jeng/asm6502/hardware/prototype_photos/FJ4s4CEXIAc8fG_.jpg

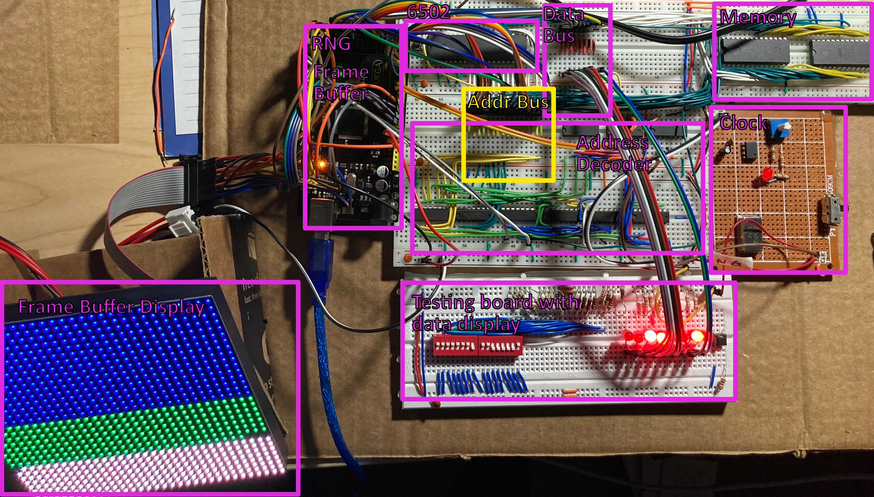
hardware/prototype_photos/FJ4s4CEXIAc8fG_.jpg
