jeng/asm6502/hardware/prototype_photos/IMG-2354.jpg

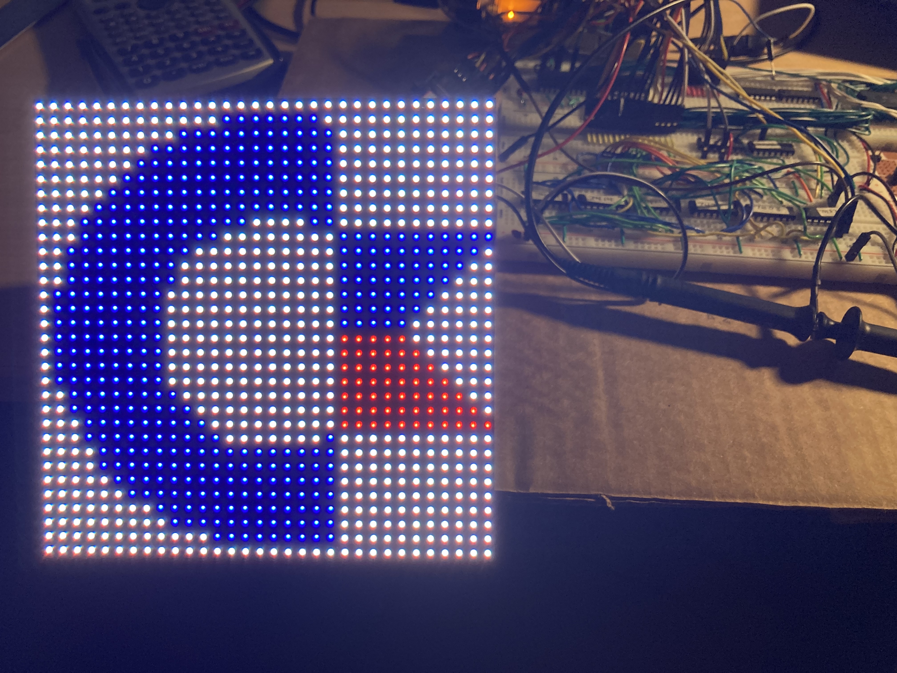
hardware/prototype_photos/IMG-2354.jpg
