jeng/asm6502/hardware/prototype_photos/bus_probe.png

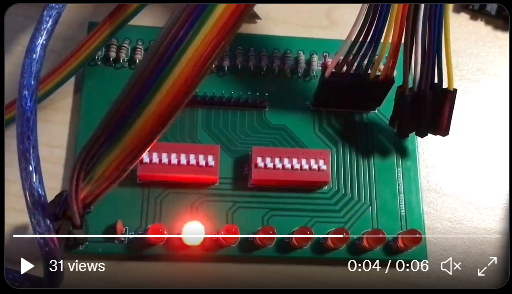
hardware/prototype_photos/bus_probe.png
