jeng/asm6502/hardware/prototype_photos/IMG-2370.jpg

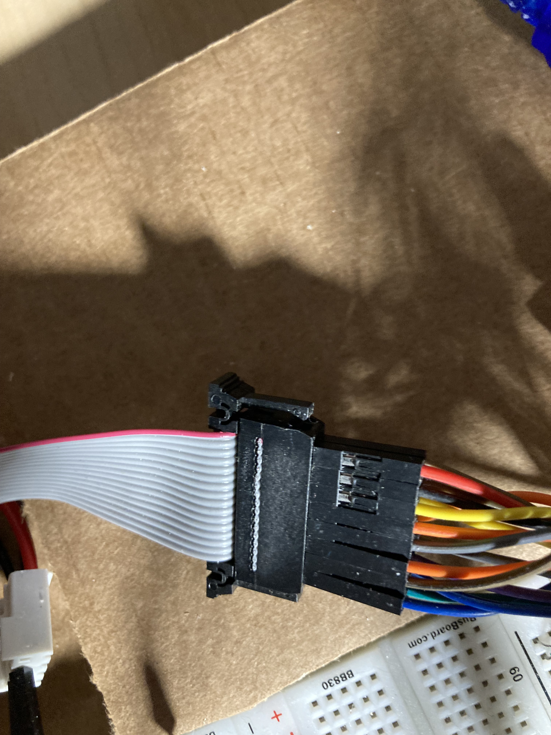
hardware/prototype_photos/IMG-2370.jpg
