jeng/asm6502/hardware/prototype_photos/v9AddressLogicFrameBuffer.png

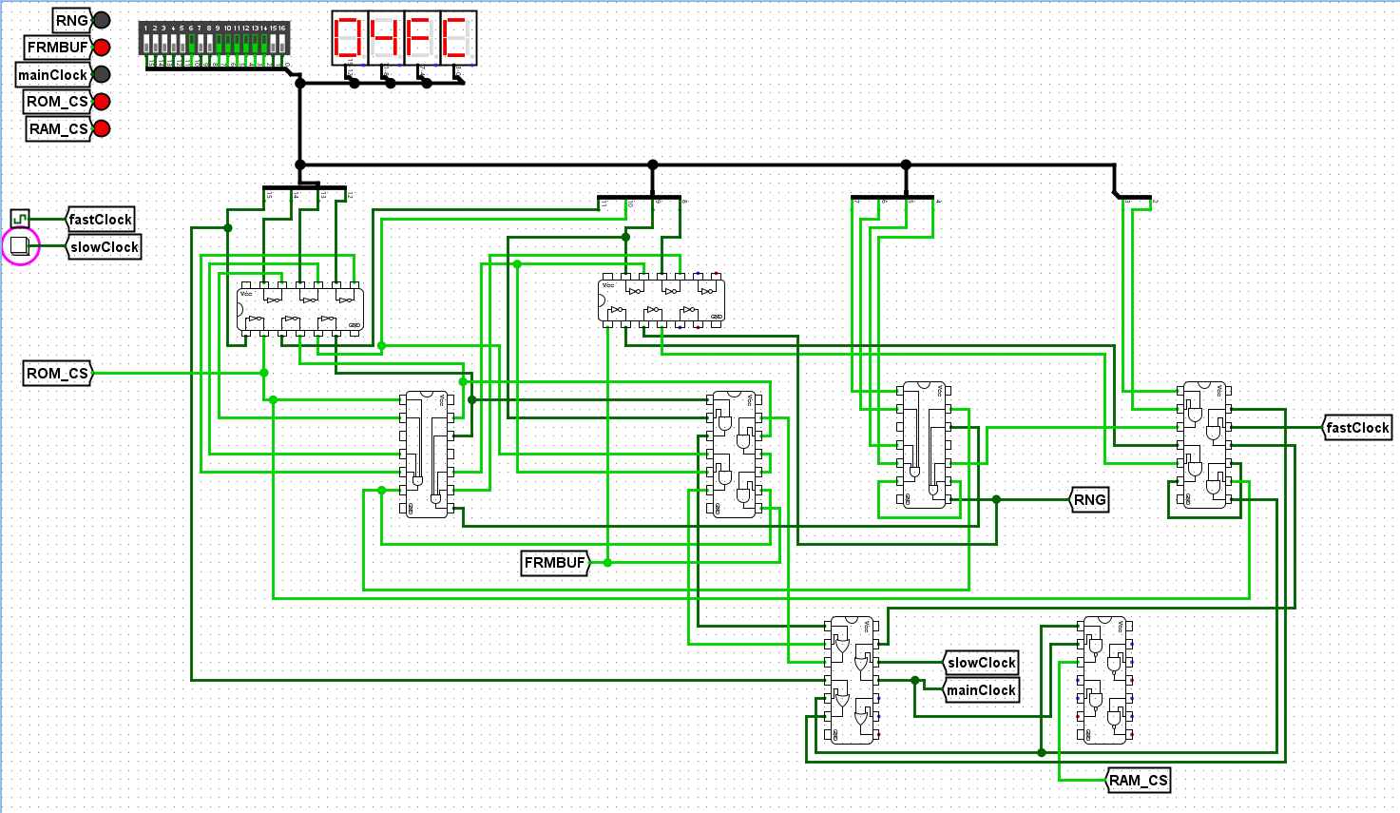
hardware/prototype_photos/v9AddressLogicFrameBuffer.png
