jeng/asm6502/hardware/simulations/addressBus.png

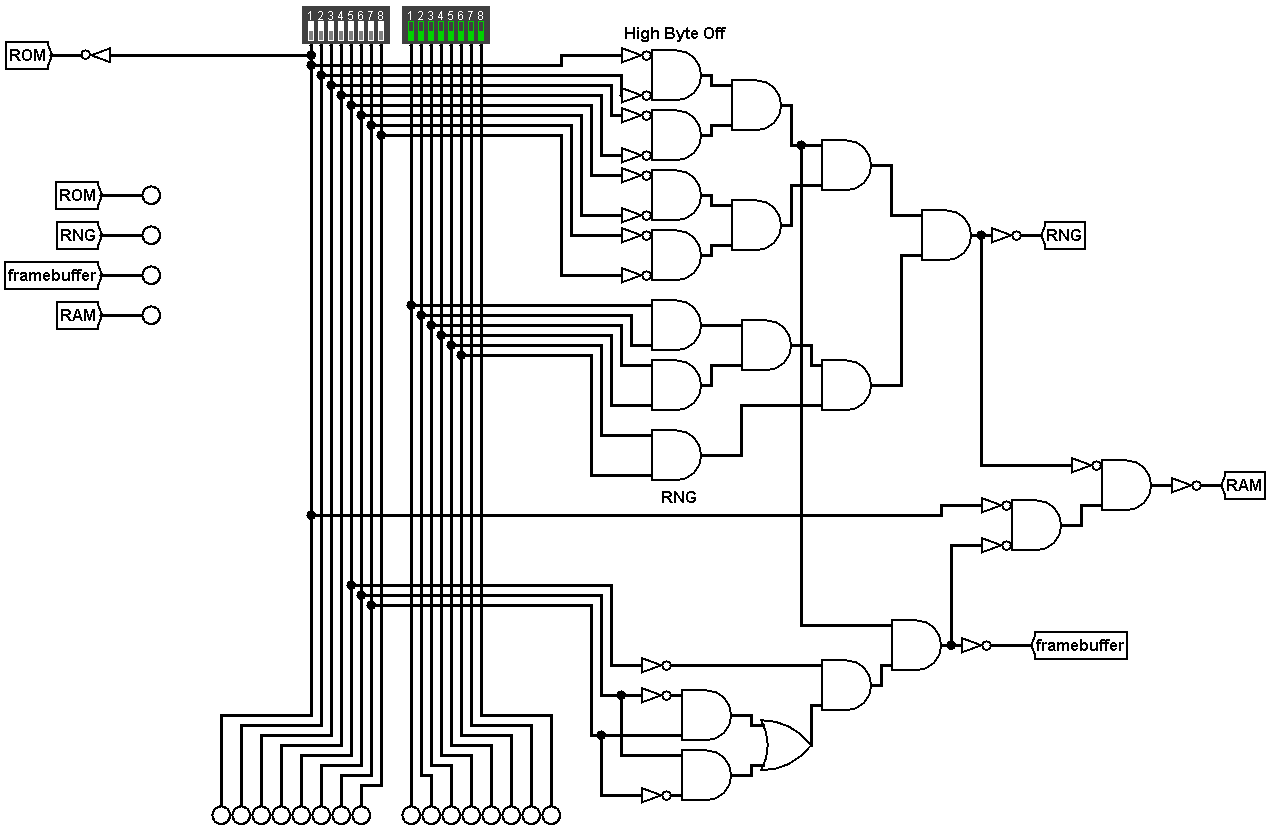
hardware/simulations/addressBus.png
