jeng/asm6502/hardware/simulations/addressBusV3.png

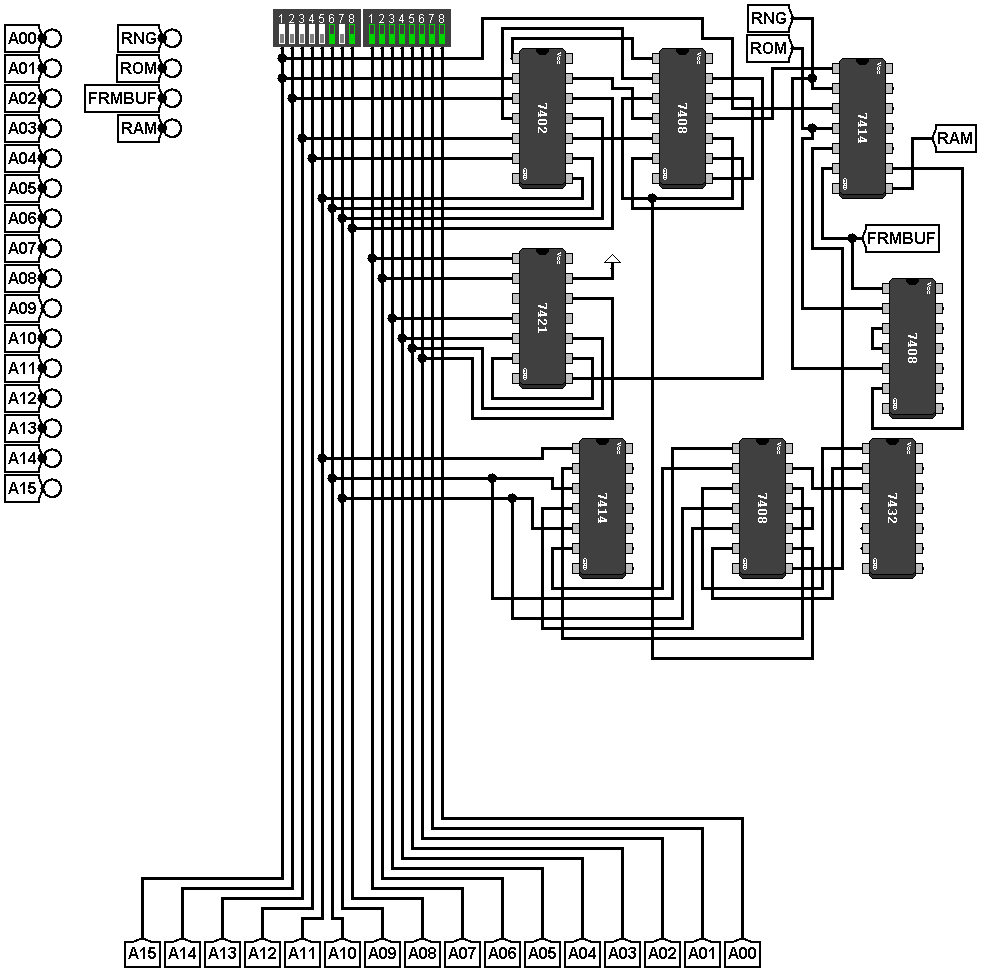
hardware/simulations/addressBusV3.png
