jeng/asm6502/hardware/simulations/addressBusV4.png

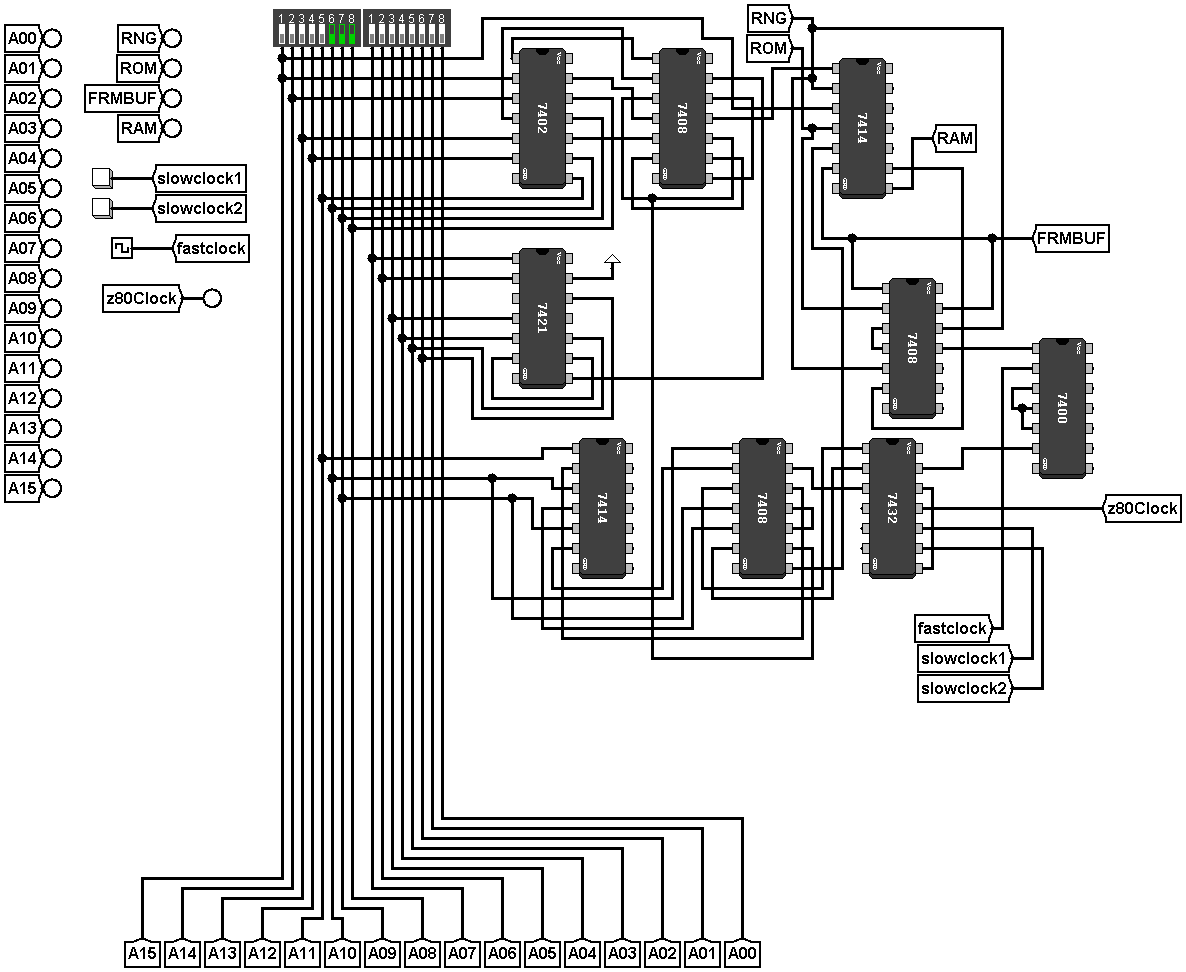
hardware/simulations/addressBusV4.png
