jeng/asm6502/hardware/simulations/memoryMapChipSelectors.png

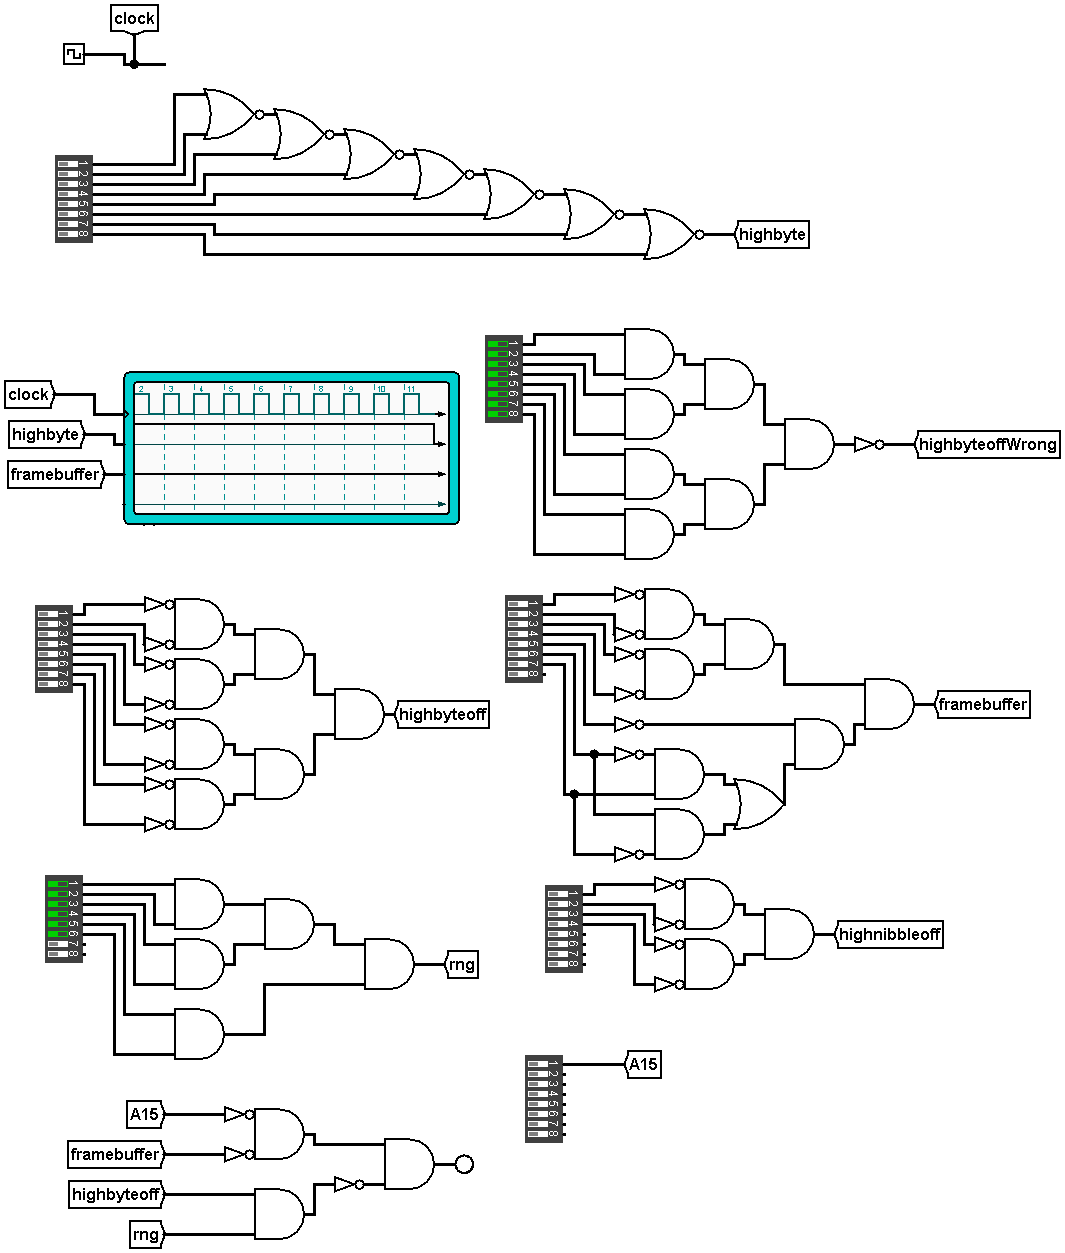
hardware/simulations/memoryMapChipSelectors.png
