jeng/asm6502/hardware/simulations/ram_rom_rng_tied_to_clock.png

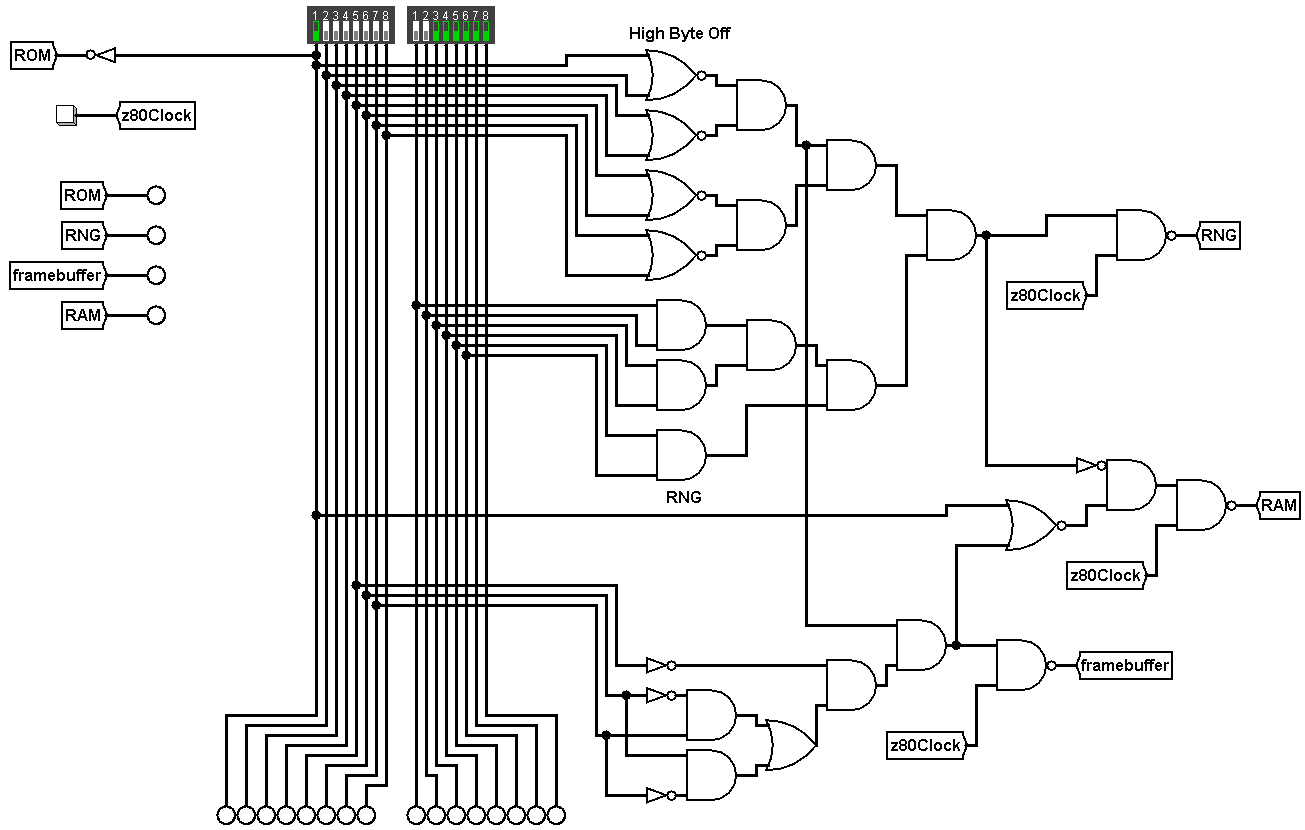
hardware/simulations/ram_rom_rng_tied_to_clock.png
