jeng/asm6502/hardware/simulations/ttlAddScrShot.png

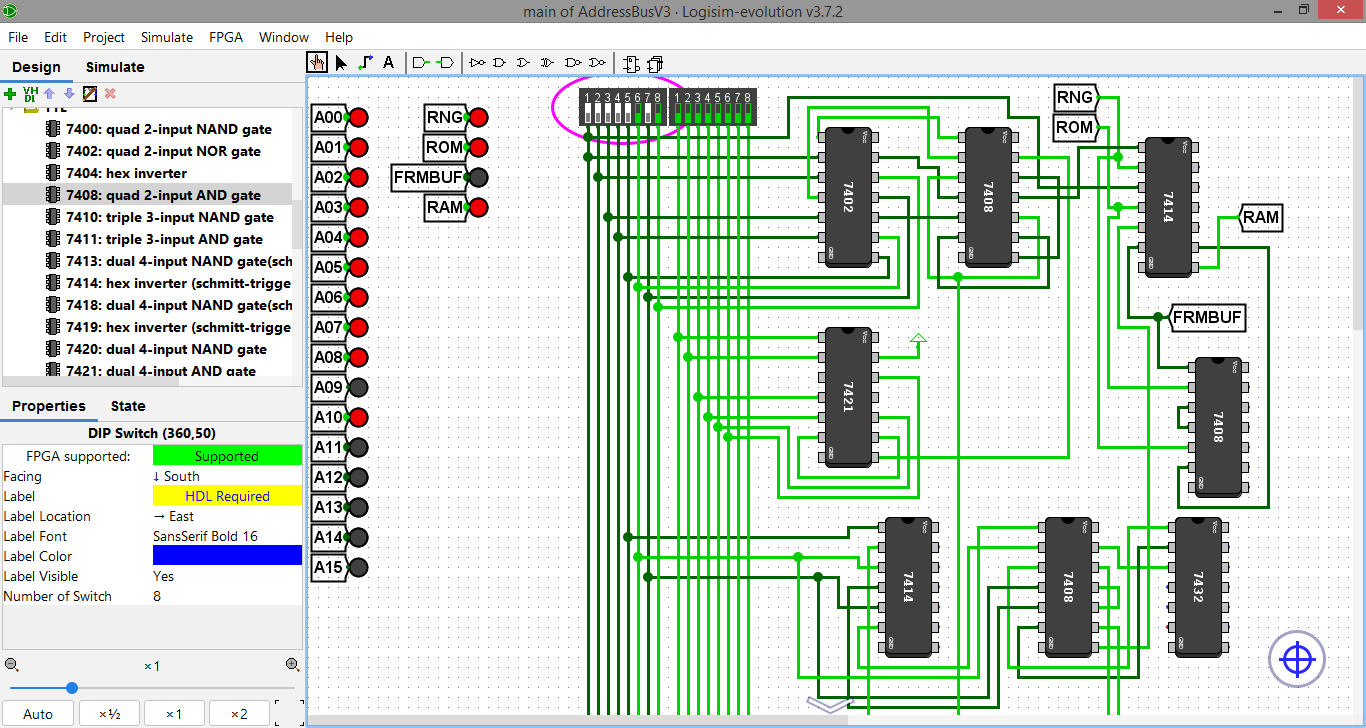
hardware/simulations/ttlAddScrShot.png
