jeng/asm6502/hardware/schematics/bus_probe/LeProbe.pdf

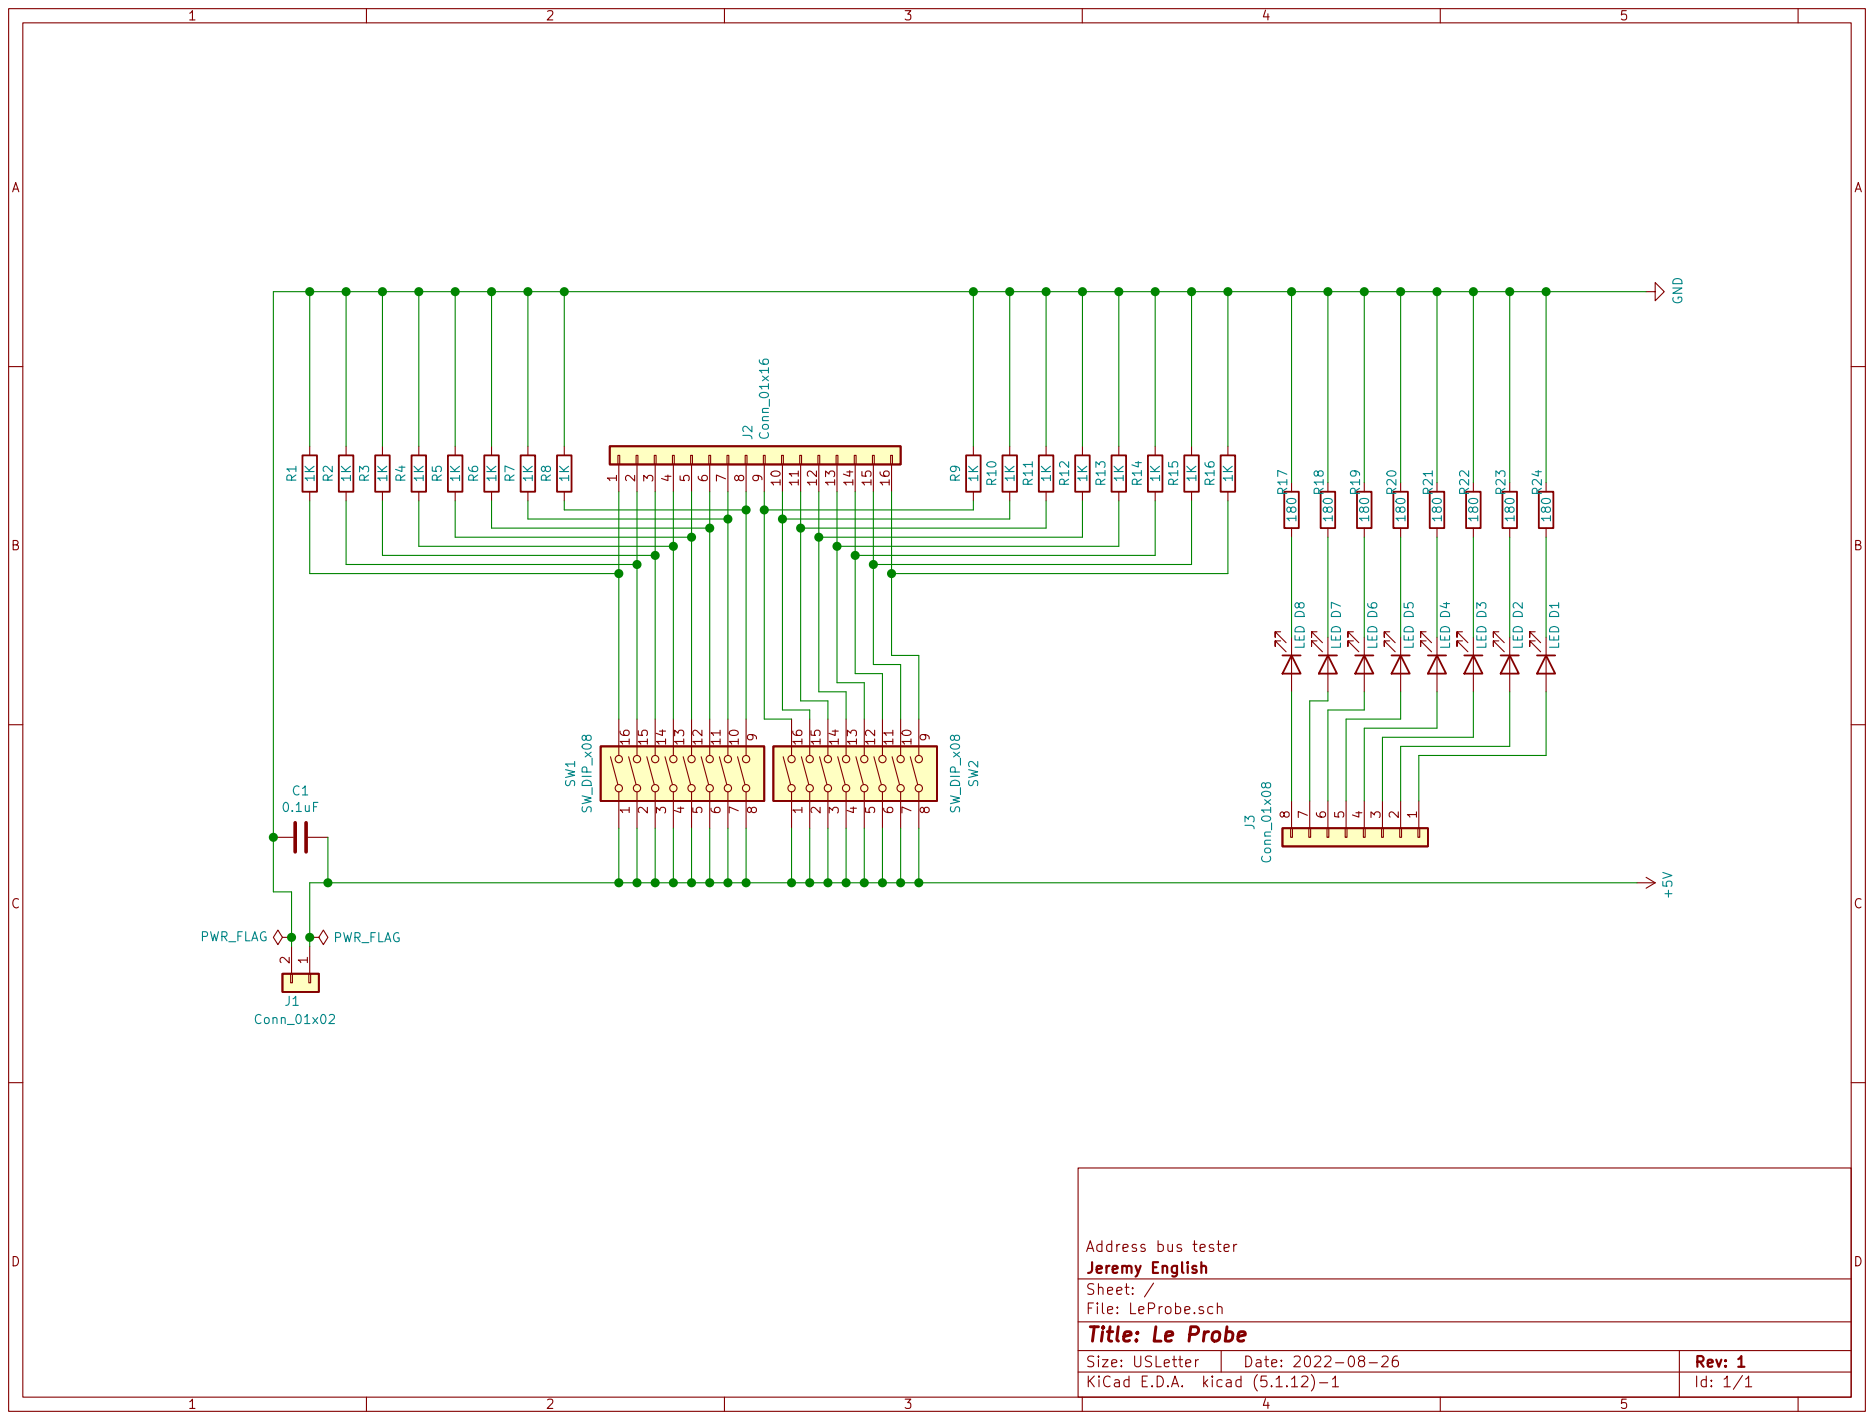
[picture p15: page 1]

Id: 1/1 Title: Le Probe
