jeng/asm6502/hardware/schematics/cpu/cpu.pdf

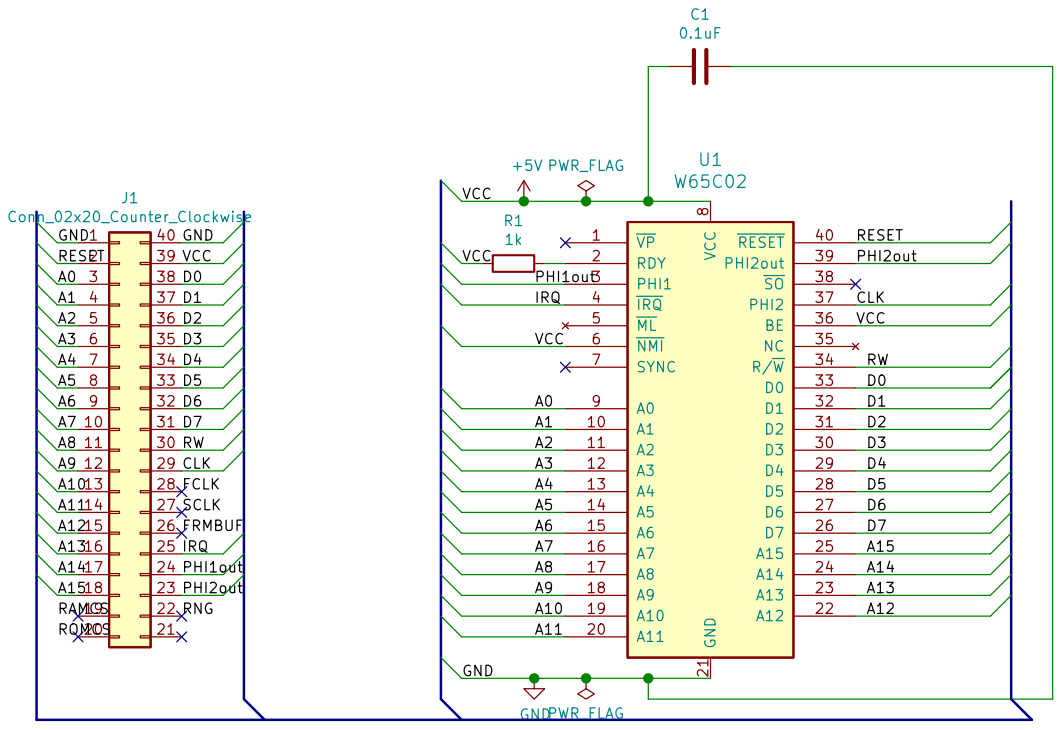
[picture p16: page 1]

8 A0 9 A1 10 A11 20 D3 30 RESET 40 A2 11 GND 21 D2 31 A3 12 A12 22 D1 32 A4 13 A13 23 D0 33 A5 14 A14 24 R/W 34 A6 15 A15 25 NC 35 A7 16 D7 26 BE 36 A8 17 D6 27 PHI2 37 A9 18 D5 28 SO 38 A10 19 D4 29 PHI2out 39 U1 W65C02
PWR_FLAG

File: cpu.sch Sheet: / Jeremy English jhe@jeremyenglish.org Hardware version of the 6502 XScreenSaver Module

Id: 1/1 Title: M6502 CPU Card
