jeng/asm6502/hardware/simulations/framebuffer_karnaugh_map.pdf

## SUM of PRODUCTS

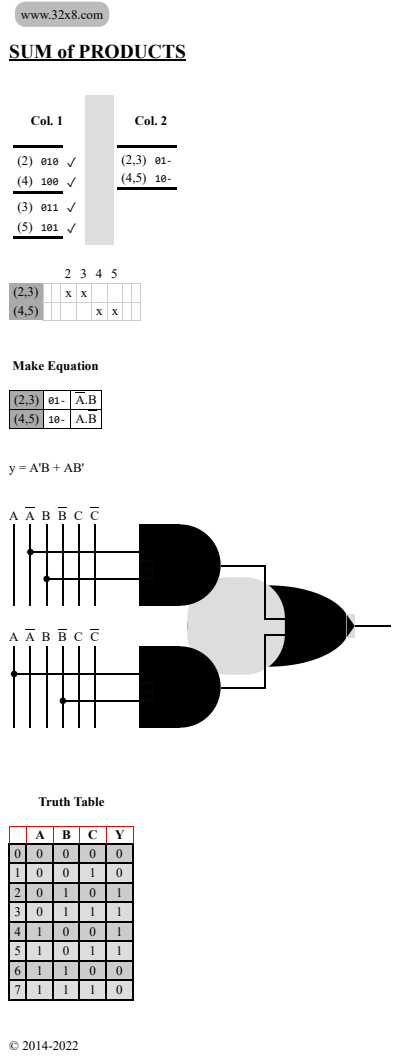
[picture p17: page 1]
www.32x8.com; Make Equation; Truth Table; Col. 1; Col. 2; www. 32x8 .com

(2,3) | 01- | A.B
(4,5) | 10- | A.B
