jeng/asm6502/hardware/schematics/memory/memory.pdf

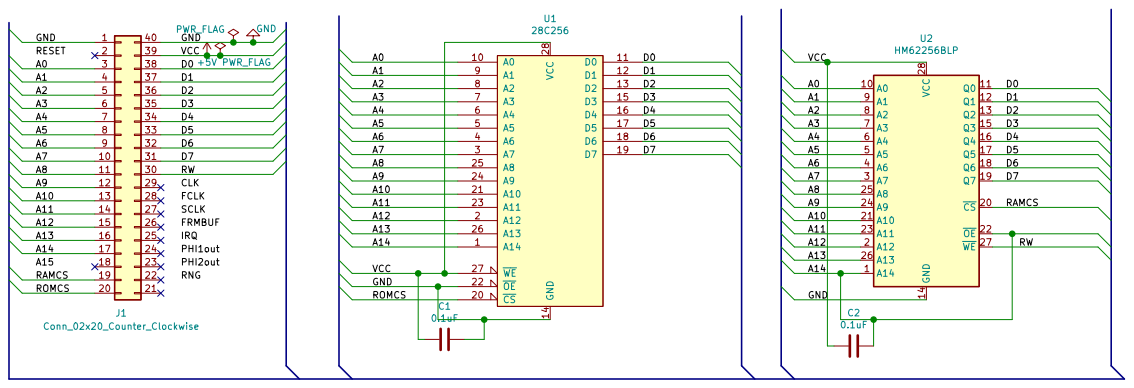
[picture p18: page 1]

Id: 1/1 Title: M6502 Memory Card
