jeng/asm6502/hardware/schematics/motherboard/motherboard.pdf

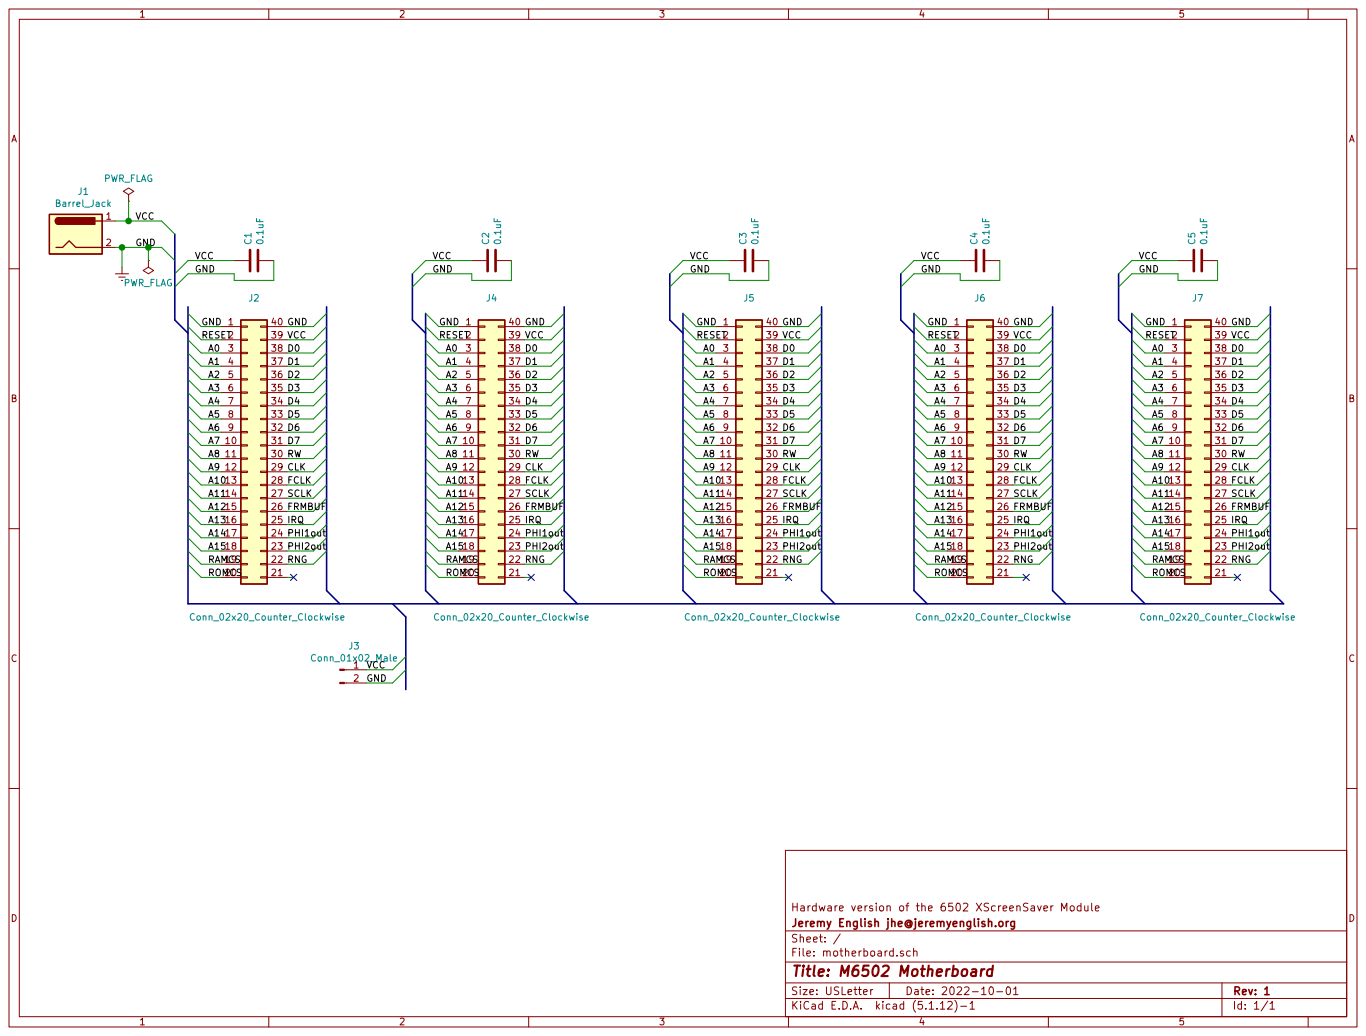
[picture p19: page 1]

File: motherboard.sch Sheet: / Jeremy English jhe@jeremyenglish.org Hardware version of the 6502 XScreenSaver Module C10.1uF
