jeng/asm6502/(list of files, drawings)

Other design files:
hardware/schematics/address_logic/address_logic.dsn
hardware/schematics/cpu/cpu.dsn
hardware/schematics/memory/memory.dsn
hardware/schematics/motherboard/motherboard.dsn
hardware/simulations/AddressBus.circ
hardware/simulations/AddressBusV2.circ
hardware/simulations/AddressBusV2_gates_with_nand.circ
hardware/simulations/AddressBusV3.circ
hardware/simulations/AddressBusV4.circ
hardware/simulations/AddressBusV5_FB_RNG_clock_high.circ
hardware/simulations/AddressBusV5_Rambug.circ
hardware/simulations/AddressBusV9_gates.circ
hardware/simulations/AddressBusV9_gates_bus.circ
hardware/simulations/AddressBusV9_ttl.circ
hardware/simulations/m6502MemoryMap.circ
hardware/simulations/OldAddressLogic/AddressBus.circ
hardware/simulations/OldAddressLogic/AddressBusV2.circ
hardware/simulations/OldAddressLogic/AddressBusV2_gates_with_nand.circ
hardware/simulations/OldAddressLogic/AddressBusV3.circ
hardware/simulations/OldAddressLogic/AddressBusV4.circ
hardware/simulations/OldAddressLogic/AddressBusV5_FB_RNG_clock_high.circ
hardware/simulations/OldAddressLogic/AddressBusV5_Rambug.circ
hardware/simulations/OldAddressLogic/AddressBusV6.circ
hardware/simulations/OldAddressLogic/AddressBusV8_gates.circ
hardware/simulations/OldAddressLogic/AddressBusV8_ttl.circ
hardware/simulations/OldAddressLogic/m6502MemoryMap.circ
