jeng/asm6502/hardware/schematics/cpu/cpu.kicad_pcb

## KiCad design 02-hardware/wireless receiver/MCU.sch

Schematic: MCU.sch

Parts:
C18: 1u; C_0603_1608Metric_Pad1.08x0.95mm_HandSolder
C19, C20, C21, C22: 100n; C_0603_1608Metric_Pad1.08x0.95mm_HandSolder
C23, C24: DNP; C_0603_1608Metric_Pad1.08x0.95mm_HandSolder
R20, R21, R22: 10k; R_0603_1608Metric_Pad0.98x0.95mm_HandSolder
R23: 0; R_0603_1608Metric_Pad0.98x0.95mm_HandSolder
R24, R25: 100k; R_0603_1608Metric_Pad0.98x0.95mm_HandSolder
U7: TCA9538; SSOP-16_5.3x6.2mm_P0.65mm
U8: REF193GSZ; SOIC-8_3.9x4.9mm_P1.27mm
U9: STM32G030_C8; LQFP-48_7x7mm_P0.5mm
Y1: Crystal_HC49CMS; Crystal_SMD_HC49-SD_HandSoldering
