jeng/asm6502/hardware/schematics/cpu/cpu.kicad_pcb

## KiCad design 02-hardware/wireless receiver/Power.sch

Schematic: Power.sch

Parts:
C2: 22u; C_1210_3225Metric_Pad1.33x2.70mm_HandSolder
C3, C4: 4.7u; C_0805_2012Metric_Pad1.18x1.45mm_HandSolder
C5: 10u; C_1206_3216Metric_Pad1.33x1.80mm_HandSolder
C6, C7: 1u; C_0603_1608Metric_Pad1.08x0.95mm_HandSolder
C8: 8.2n; C_0603_1608Metric_Pad1.08x0.95mm_HandSolder
C9: 100n; C_0603_1608Metric_Pad1.08x0.95mm_HandSolder
C10, C11: 4.7u; C_0603_1608Metric_Pad1.08x0.95mm_HandSolder
C12: 33p; C_0603_1608Metric_Pad1.08x0.95mm_HandSolder
C13: 1n; C_0603_1608Metric_Pad1.08x0.95mm_HandSolder
C14, C15: 47u; C_1210_3225Metric_Pad1.33x2.70mm_HandSolder
D3: B340A; D_SMA_Handsoldering
L1: 3.3u; L_Vishay_IHLP-2525
R9: 100k; R_0603_1608Metric_Pad0.98x0.95mm_HandSolder
R10: 42.2k; R_0603_1608Metric_Pad0.98x0.95mm_HandSolder
R11: 10k; R_0603_1608Metric_Pad0.98x0.95mm_HandSolder
R12: 2k; R_0603_1608Metric_Pad0.98x0.95mm_HandSolder
U2: TPS54332; SOIC-8-1EP_3.9x4.9mm_P1.27mm_EP2.29x3mm
U3: MCP1804T-5002I_O; SOT-23-5
U4: MCP1804T-3302I_O; SOT-23-5
