jeng/asm6502/hardware/schematics/cpu/cpu.kicad_pcb

## KiCad design 02-hardware/wireless receiver/analog_input_stage.sch

Schematic: analog_input_stage.sch

Parts:
C25: 100n; C_0603_1608Metric_Pad1.08x0.95mm_HandSolder
R26, R27, R28: 10k; R_0603_1608Metric_Pad0.98x0.95mm_HandSolder
R29, R30, R31, R32, R33, R34: TBD; R_0603_1608Metric_Pad0.98x0.95mm_HandSolder
R35, R36: R_0603; R_0603_1608Metric_Pad0.98x0.95mm_HandSolder
U10: LMV824AIYDT; SO-14_3.9x8.65mm_P1.27mm
U11: MCP6N11-001E_SN; SOIC-8_3.9x4.9mm_P1.27mm
