jeng/asm6502/hardware/schematics/cpu/cpu.kicad_pcb

## KiCad design 02-hardware/wireless receiver/input_stage.sch

Schematic: input_stage.sch

Parts:
C26: 100n; C_0603_1608Metric_Pad1.08x0.95mm_HandSolder
U12: 74HCT244; SOIC-20W_7.5x12.8mm_P1.27mm
