jeng/asm6502/hardware/schematics/cpu/cpu.kicad_pcb

## KiCad design 02-hardware/wireless receiver/output_stage.sch

Schematic: output_stage.sch

Parts:
C16, C17: 100n; C_0603_1608Metric_Pad1.08x0.95mm_HandSolder
D4, D5, D6, D7, D8: 1N4148WS; D_SOD-323_HandSoldering
Q1, Q2, Q3, Q4, Q5: BC848B; SOT-23
R13: 0; R_0603_1608Metric_Pad0.98x0.95mm_HandSolder
R14: DNP; R_0603_1608Metric_Pad0.98x0.95mm_HandSolder
R15, R16, R17, R18, R19: 10k; R_0603_1608Metric_Pad0.98x0.95mm_HandSolder
U5, U6: 74HCT244; SOIC-20W_7.5x12.8mm_P1.27mm
