jeng/asm6502/(commit log)

2007-04-17 A port, to c, of the javascript 6502 assembler and emulator.
2007-04-19 Just about have the assembler finished.
2007-04-20 Cool, The assembler seems to be working! My hexdump matches the target hexdump off of the website.
2007-04-20 The output for the assembler matches all of the output on the website. I'm not real happy with the parser it could use some work. Write now it will break if extra spaces are in the parameter. I could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
2007-04-23 Two important lessons I learned here. The one I should have known is, don't prototype in C. The other one is, table driven parsing is not as elegenant as recursion.
    That leaves me rewritting the tolkenizer, which I don't really need,
    and the parameter parser.
2007-04-27 Completed some of the opcode stubs, added a trace routine, changed the way regP was handled, and created test.asm to test the emulator.
2007-05-01 All of the opcodes except add and substract are implemented. The trace function has been inhanced.
    I would like to break the trace out into a seperate debugger.
    I'm going to add ascii output for now so I can test the graphics.
2007-05-04 Caching the opcode indexes cut the runtime of opindex down from 60% to 4%.
2007-05-10 Added error checking for assembler parameters.
2007-07-22 Included the screensaver m6502, changed pong.asm and spacer.asm so that they would work without user interaction.
2007-07-22 Changed the screensaver so that it would pull the assembly files out of the image/m6502 directory. Added a function to the assembler so that it will take a string as code. The same demo can not run c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
2007-08-04 Added the debugger to the archive. The assembler will now let you disassemble the program that is loaded in memory.
2008-01-13 I bumped the version number of the debugger, deleted the duplicate assembly fileand added a copywrite statement to the dcb dumper.
2008-10-17 I added some new assembly files I found on 6502asm.com.
    The colors.asm has a bug in it. It looks like it tries to read bytes
    past the dcb table.
    For some reason starfield2d doesn't work the same on the
    screensaver. The stars are flying past way to fast.
2008-10-18 Added the screensaver configuration file and manpage.
    Added a script that will run all asm files in a directory for 30
    seconds a piece.
    Made a minor change to colors.asm, the load address should have been
    $700 instead of $7000. We want to just be out of reach of the frame
    buffer which ends a $600
2008-11-22 Author: Jeremy English <jeremy.english@gmail.com> --- log message follows this line ---
    Added a delay to the start field program. I should probable figure out
    a way to throttle the instructions. That way the assembly programs
    could run at a true, blazing fast, 1MHz.
2008-12-02 Added a snowflake generating assembly program.
2009-05-24 Added a fire demo. It is really slow at the moment. It makes one pass through the frame buffer, makes changes to an offscreen buffer and then repaints the entire frame buffer. I need to figure out a 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
2022-09-24 Initial upload for the hardware prototype
    Nothing here is close to being finalized. I have it running on a
    breadboard with some successful output. I still need to make the
    schematic, order the pcbs and finalize the firmware.
    I wanted to upload it now so I don't lose track even though I'm not
    crazy about having this stuff public since it is all hacky at the
    moment.
    [AddressBus.circ, AddressBusV2.circ, AddressBusV2_gates_with_nand.circ, AddressBusV3.circ, AddressBusV4.circ, AddressBusV5_FB_RNG_clock_high.circ, AddressBusV5_Rambug.circ, m6502MemoryMap.circ]
2022-09-25 I added a new address logic simulation
    I also uploaded the schematics for the very simple bus probe.
    [AddressBus.circ, AddressBusV2.circ, AddressBusV2_gates_with_nand.circ, AddressBusV3.circ, AddressBusV4.circ, AddressBusV5_FB_RNG_clock_high.circ, AddressBusV5_Rambug.circ, AddressBusV6.circ]
2022-09-25 I added the bus probe photo.
2022-10-01 I started on the schematics
    [AddressBusV9_gates_bus.circ, AddressBusV9_ttl.circ, address_logic.kicad_pcb, address_logic.sch, motherboard.kicad_pcb, motherboard.sch]
2022-10-01 I added the initial versions on the cpu and memory card
    [cpu.kicad_pcb, cpu.sch, memory.kicad_pcb, memory.sch, motherboard.sch]
2022-10-04 I started working on the PCBs
    [address_logic.dsn, address_logic.sch, cpu.dsn, cpu.sch, memory.sch, motherboard.dsn, motherboard.sch]
2022-10-06 I ordered the PCB from jlcpcb
    [address_logic-B_Cu.gbl, address_logic-B_Mask.gbs, address_logic-B_Paste.gbp, address_logic-B_SilkS.gbo, address_logic-Edge_Cuts.gm1, address_logic-F_Cu.gtl, address_logic-F_Mask.gts, address_logic-F_Paste.gtp]
2022-10-08 I added pdf files of the schematics
