jeng/asm6502/hardware/prototype_photos/IMG-2203.jpg

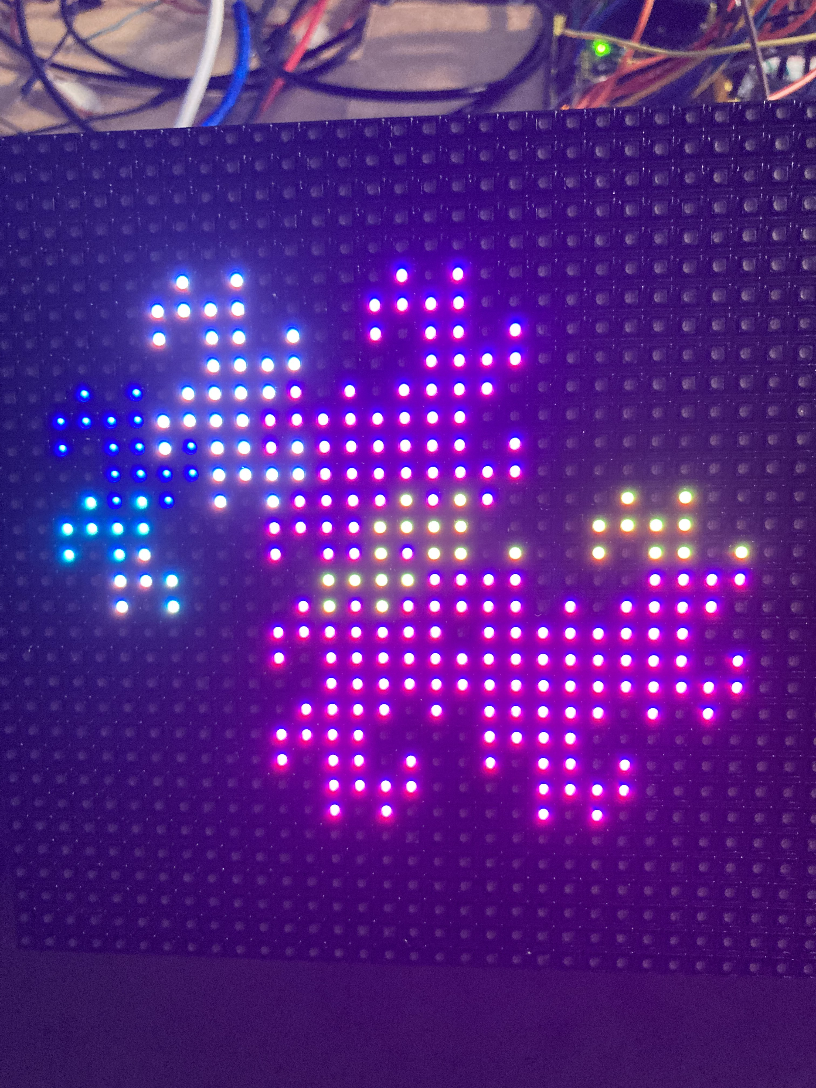
hardware/prototype_photos/IMG-2203.jpg
