jeng/asm6502/hardware/prototype_photos/IMG-2362.jpg

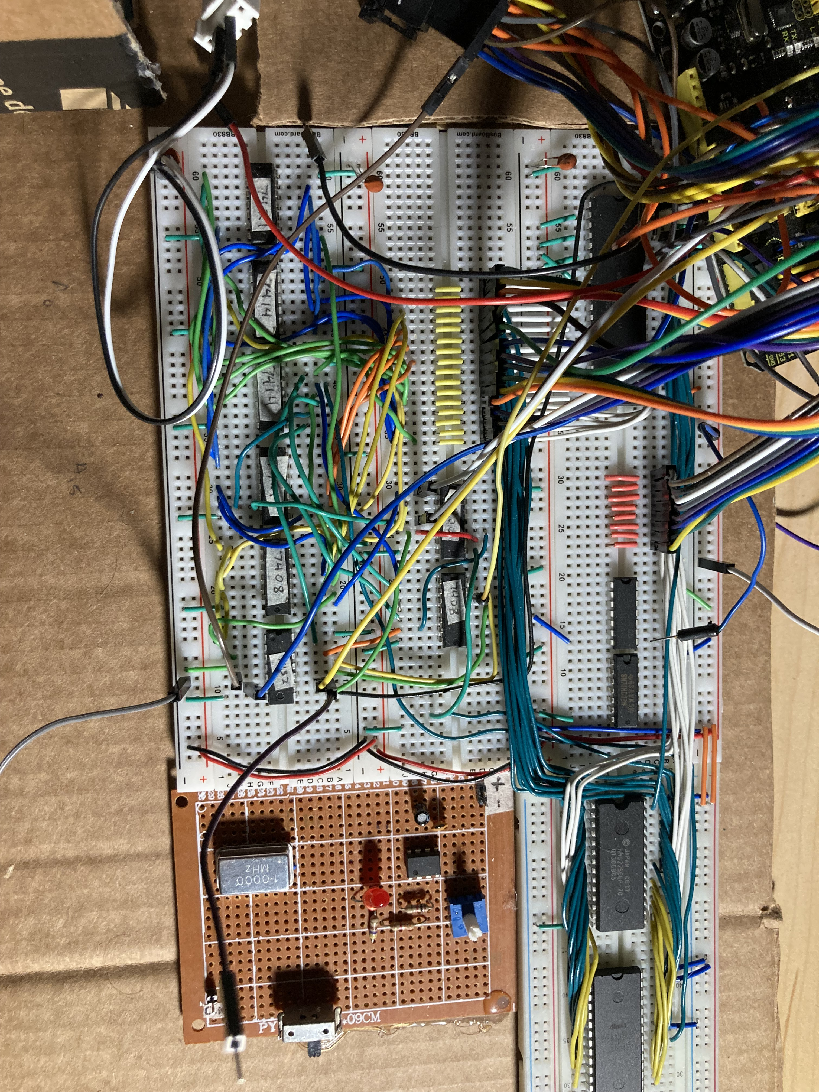
hardware/prototype_photos/IMG-2362.jpg
