jeng/asm6502/hardware/prototype_photos/IMG-2363.jpg

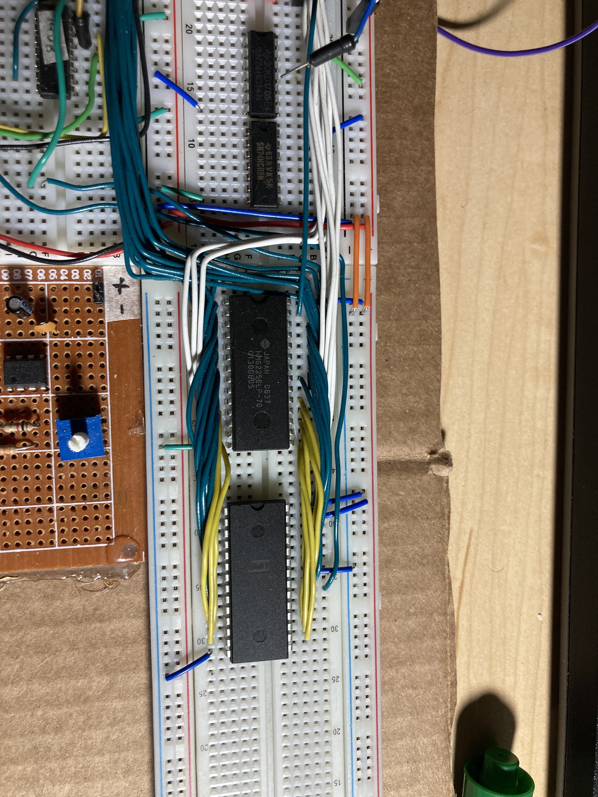
hardware/prototype_photos/IMG-2363.jpg
